Samuel20040521/flico/hardware/final-version/Gerber/SOC_Final_BOM.csv

Comment | Designator | Footprint | Quantity | Description | LCSC
0.1p | C1 | Capacitor_SMD:C_0603_1608Metric_Pad1.08x0.95mm_HandSolder | 1 | Capacitor 0.1p 0603
1p | C2 | Capacitor_SMD:C_0603_1608Metric_Pad1.08x0.95mm_HandSolder | 1 | Capacitor 1p 0603
10p | C3 | Capacitor_SMD:C_0603_1608Metric_Pad1.08x0.95mm_HandSolder | 1 | Capacitor 10p 0603
100p | C4 | Capacitor_SMD:C_0603_1608Metric_Pad1.08x0.95mm_HandSolder | 1 | Capacitor 100p 0603
1n | C5 | Capacitor_SMD:C_0603_1608Metric_Pad1.08x0.95mm_HandSolder | 1 | Capacitor 1n 0603
10n | C6 | Capacitor_SMD:C_0603_1608Metric_Pad1.08x0.95mm_HandSolder | 1 | Capacitor 10n 0603
100n | C7 | Capacitor_SMD:C_0603_1608Metric_Pad1.08x0.95mm_HandSolder | 1 | Capacitor 100n 0603
1u | C8 | Capacitor_SMD:C_0603_1608Metric_Pad1.08x0.95mm_HandSolder | 1 | Capacitor 1u 0603
Conn_01x03_Socket | J1 | Connector_PinSocket_2.54mm:PinSocket_1x03_P2.54mm_Vertical | 1 | Pin header/socket
Conn_01x04_Socket | J3 | Connector_PinSocket_2.54mm:PinSocket_1x04_P2.54mm_Vertical | 1 | Pin header/socket
100M | R1 | Resistor_SMD:R_0603_1608Metric_Pad0.98x0.95mm_HandSolder | 1 | Resistor 100M 0603
1k | R2,R8 | Resistor_SMD:R_0603_1608Metric_Pad0.98x0.95mm_HandSolder | 2 | Resistor 1k 0603
32k | R3 | Resistor_SMD:R_0603_1608Metric_Pad0.98x0.95mm_HandSolder | 1 | Resistor 32k 0603
10M | R4 | Resistor_SMD:R_0603_1608Metric_Pad0.98x0.95mm_HandSolder | 1 | Resistor 10M 0603
1M | R5 | Resistor_SMD:R_0603_1608Metric_Pad0.98x0.95mm_HandSolder | 1 | Resistor 1M 0603
100k | R6 | Resistor_SMD:R_0603_1608Metric_Pad0.98x0.95mm_HandSolder | 1 | Resistor 100k 0603
10k | R7 | Resistor_SMD:R_0603_1608Metric_Pad0.98x0.95mm_HandSolder | 1 | Resistor 10k 0603
100 | R9 | Resistor_SMD:R_0603_1608Metric_Pad0.98x0.95mm_HandSolder | 1 | Resistor 100 0603
10 | R10 | Resistor_SMD:R_0603_1608Metric_Pad0.98x0.95mm_HandSolder | 1 | Resistor 10 0603
SFH2440 | SFH2440 | OptoDevice:Osram_SFH2440 | 1 | SFH2440
OPA320AIDBVR | U1 | OPA320AIDBVR:SOT95P280X145-5N | 1 | IC OPA320AIDBVR
TMUX1208PW | U2 | Package_SO:TSSOP-16_4.4x5mm_P0.65mm | 1 | IC TMUX1208PW
