Samuel20040521/flico/hardware/second-version/PD_detector_pro.kicad_pcb

## KiCad design hardware/second-version/PD_detector_pro.kicad_pcb (2026-06-07)

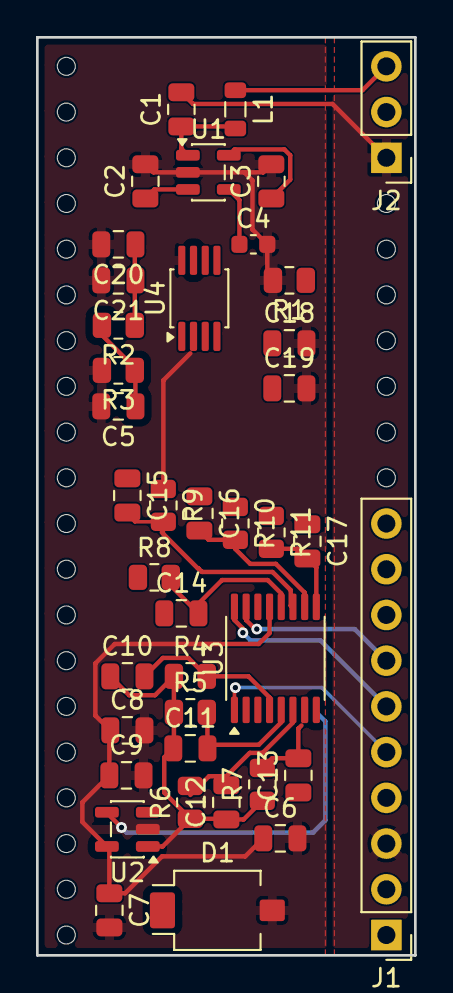
[picture p15: board PD_detector_pro.kicad_pcb from above]

Board: 2 copper layers, 21.0 x 51.0 mm, 41 parts (0 on the bottom side), 24 nets.

Parts:
C1, C2, C3: 1uF; C_0805_2012Metric
C4: 10nF; C_0603_1608Metric
C5, C6, C8, C18, C20: 100nF; C_0805_2012Metric
C7, C9, C19, C21: 10uF; C_0805_2012Metric
C10: 10nF; C_0805_2012Metric
C11: 3.3nF; C_0805_2012Metric
C12: 1nF; C_0805_2012Metric
C13: 330pF; C_0805_2012Metric
C14: 100pF; C_0805_2012Metric
C15: 33pF; C_0805_2012Metric
C16: 10pF; C_0805_2012Metric
C17: DNP; C_0805_2012Metric
D1: SFH2440; Osram_SFH2440
J1: Conn_01x10; PinHeader_1x10_P2.54mm_Vertical
J2: Conn_01x03; PinHeader_1x03_P2.54mm_Vertical
L1: 600R@100MHz; L_0805_2012Metric
PICO_PINS: Pico_thru
R1: 0; R_0805_2012Metric
R2, R8: 100k; R_0805_2012Metric
R3: 4.7k; R_0805_2012Metric
R4: 1k; R_0805_2012Metric
R5: 3.3k; R_0805_2012Metric
R6: 10k; R_0805_2012Metric
R7: 33k; R_0805_2012Metric
R9: 330k; R_0805_2012Metric
R10: 1M; R_0805_2012Metric
R11: 10M; R_0805_2012Metric
U1: LP5907MFX-3.3; SOT-23-5
U2: OPA320AIDBVR; SOT-23-5
U3: TMUX1208PWR; TSSOP-16_4.4x5mm_P0.65mm
U4: ADS8326; MSOP-8_3x3mm_P0.65mm

Connections:
+3V3_A: C3.1, C6.1, C7.1, C8.1, C9.1, C18.1, C19.1, C20.1, C21.1, R2.1, U1.5, U2.5, U3.13, U4.1, U4.8
GEAR0: C10.2, R4.2, U3.4
GEAR1: C11.2, R5.2, U3.5
GEAR2: C12.2, R6.2, U3.6
GEAR3: C13.2, R7.2, U3.7
GEAR4: C14.2, R8.2, U3.12
GEAR5: C15.2, R9.2, U3.11
GEAR6: C16.2, R10.2, U3.10
GEAR7: C17.2, R11.2, U3.9
GND: C1.2, J1.3, J2.1, R1.1
GNDA: C2.2, C3.2, C4.2, C5.2, C6.2, C7.2, C8.2, C9.2, C18.2, C19.2, C20.2, C21.2, D1.2, R1.2, R3.2, U1.2, U2.2, U3.14, U4.4
LDO_BYP: C4.1, U1.4
MUX_A0: J1.5, U3.1
MUX_A1: J1.6, U3.16
MUX_A2: J1.7, U3.15
MUX_EN: J1.8, U3.2
SPI_CS: J1.2, U4.5
SPI_SCK: J1.4, U4.7
SPI_SDO: J1.1, U4.6
TIA_OUT: C10.1, C11.1, C12.1, C13.1, C14.1, C15.1, C16.1, C17.1, R4.1, R5.1, R6.1, R7.1, R8.1, R9.1, R10.1, R11.1, U2.1, U4.2
TIA_SUM: D1.1, U2.4, U3.8
VBUS: J2.3, L1.1
VBUS_FILT: C1.1, C2.1, L1.2, U1.1, U1.3
V_REF: C5.1, R2.2, R3.1, U2.3, U4.3
