Samuel20040521/flico/hardware/first-version/pico_flicker_shield.kicad_pcb

## KiCad design hardware/first-version/pico_flicker_shield.kicad_pcb (2026-06-07)

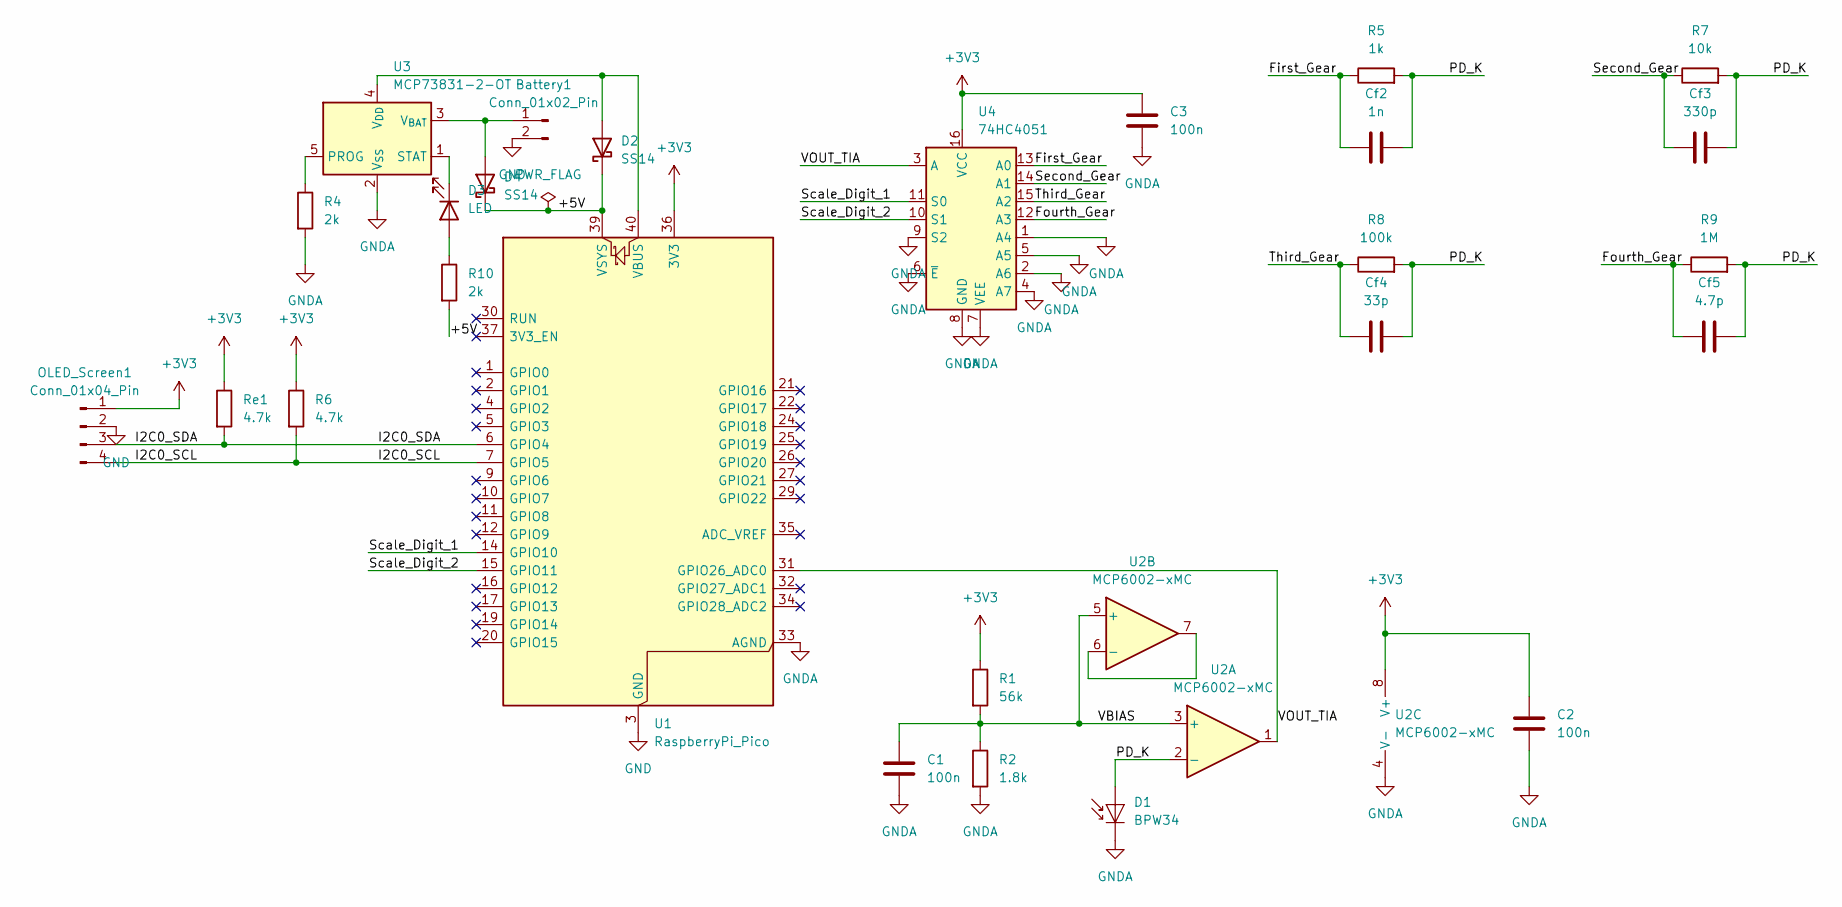
[picture p16: schematic pico_flicker_shield.kicad_sch]

Parts:
Battery1: Conn_01x02_Pin
C1, C3: 100n; C_0805_2012Metric; LCSC C49645
C2: 100n; C_0805_2012Metric
Cf2: 1n; C_0805_2012Metric
Cf3: 330p; C_0805_2012Metric
Cf4: 33p; C_0805_2012Metric
Cf5: 4.7p; C_0805_2012Metric
D1: BPW34; Osram_DIL2_4.3x4.65mm_P5.08mm
D2, D4: SS14; D_SMA
D3: LED; LED_0805_2012Metric
OLED_Screen1: Conn_01x04_Pin; PinHeader_1x04_P2.54mm_Vertical
R1: 56k; R_0805_2012Metric; LCSC C17414
R2: 1.8k; R_0805_2012Metric
R4, R10: 2k; R_0805_2012Metric; LCSC C17414
R5: 1k; R_0805_2012Metric
R6: 4.7k; R_0805_2012Metric; LCSC C17630
R7: 10k; R_0805_2012Metric
R8: 100k; R_0805_2012Metric
R9: 1M; R_0805_2012Metric
Re1: 4.7k; R_0805_2012Metric; LCSC C17630
U1: RaspberryPi_Pico; RaspberryPi_Pico_Common_THT
U2: MCP6002-xMC; MSOP-8_3x3mm_P0.65mm
U3: MCP73831-2-OT; SOT-23-5
U4: 74HC4051; SOIC-16_3.9x9.9mm_P1.27mm

Connections:
+3V3: C2.1, C3.1, OLED_Screen1.1, R1.1, R6.1, Re1.1, U1.36 (3V3), U2.8 (V+), U4.16 (VCC)
/+5V: D2.1 (K), D4.1 (K), R10.2, U1.39 (VSYS)
/First_Gear: Cf2.1, R5.1, U4.13 (A0)
/Fourth_Gear: Cf5.1, R9.1, U4.12 (A3)
/I2C0_SCL: OLED_Screen1.4, R6.2, U1.7 (GPIO5)
/I2C0_SDA: OLED_Screen1.3, Re1.2, U1.6 (GPIO4)
/PD_K: Cf2.2, Cf3.2, Cf4.2, Cf5.2, D1.2 (A), R5.2, R7.2, R8.2, R9.2, U2.2 (-)
/Scale_Digit_1: U1.14 (GPIO10), U4.11 (S0)
/Scale_Digit_2: U1.15 (GPIO11), U4.10 (S1)
/Second_Gear: Cf3.1, R7.1, U4.14 (A1)
/Third_Gear: Cf4.1, R8.1, U4.15 (A2)
/VBIAS: C1.1, R1.2, R2.1, U2.3 (+), U2.5 (+)
/VOUT_TIA: U1.31 (GPIO26_ADC0), U2.1, U4.3 (A)
GND: Battery1.2, OLED_Screen1.2, U1.3 (GND), U1.8 (GND), U1.13 (GND), U1.18 (GND), U1.23 (GND), U1.28 (GND), U1.38 (GND)
GNDA: C1.2, C2.2, C3.2, D1.1 (K), R2.2, R4.2, U1.33 (AGND), U2.4 (V-), U2.9 (V-), U3.2 (V_{SS}), U4.1 (A4), U4.2 (A6), U4.4 (A7), U4.5 (A5), U4.6 (~E), U4.7 (VEE), U4.8 (GND), U4.9 (S2)
unnamed: Battery1.1, D4.2 (A), U3.3 (V_{BAT})
unnamed: D2.2 (A), U1.40 (VBUS), U3.4 (V_{DD})
unnamed: D3.2 (A), R10.1
unnamed: D3.1 (K), U3.1 (STAT)
unnamed: U2.6 (-), U2.7
unnamed: R4.1, U3.5 (PROG)

Board: 2 copper layers, 26 parts (0 on the bottom side), 21 nets, no tracks yet.
