Samuel20040521/flico/hardware/final-version/SOC_Final.kicad_pcb

## KiCad design hardware/final-version/SOC_Final.kicad_pcb (2026-06-07)

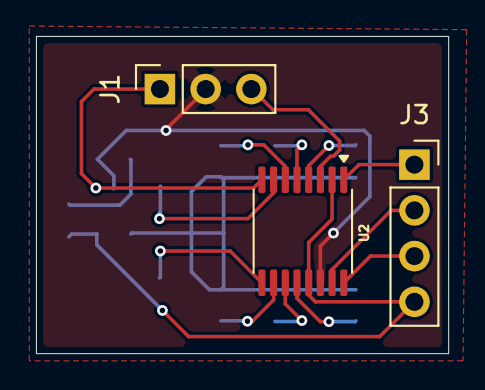
[picture p17: board SOC_Final.kicad_pcb from above]

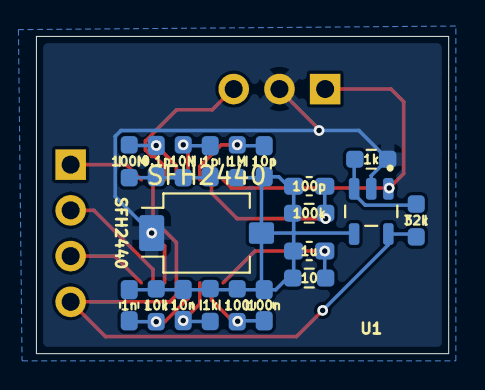
[picture p18: board SOC_Final.kicad_pcb from below]

Board: 2 copper layers, 22.9 x 17.6 mm, 23 parts (20 on the bottom side), 17 nets.

Parts:
C1: 0.1p; C_0603_1608Metric_Pad1.08x0.95mm_HandSolder
C2: 1p; C_0603_1608Metric_Pad1.08x0.95mm_HandSolder
C3: 10p; C_0603_1608Metric_Pad1.08x0.95mm_HandSolder
C4: 100p; C_0603_1608Metric_Pad1.08x0.95mm_HandSolder
C5: 1n; C_0603_1608Metric_Pad1.08x0.95mm_HandSolder
C6: 10n; C_0603_1608Metric_Pad1.08x0.95mm_HandSolder
C7: 100n; C_0603_1608Metric_Pad1.08x0.95mm_HandSolder
C8: 1u; C_0603_1608Metric_Pad1.08x0.95mm_HandSolder
J1: Conn_01x03_Socket; PinSocket_1x03_P2.54mm_Vertical
J3: Conn_01x04_Socket; PinSocket_1x04_P2.54mm_Vertical
R1: 100M; R_0603_1608Metric_Pad0.98x0.95mm_HandSolder
R2, R8: 1k; R_0603_1608Metric_Pad0.98x0.95mm_HandSolder
R3: 32k; R_0603_1608Metric_Pad0.98x0.95mm_HandSolder
R4: 10M; R_0603_1608Metric_Pad0.98x0.95mm_HandSolder
R5: 1M; R_0603_1608Metric_Pad0.98x0.95mm_HandSolder
R6: 100k; R_0603_1608Metric_Pad0.98x0.95mm_HandSolder
R7: 10k; R_0603_1608Metric_Pad0.98x0.95mm_HandSolder
R9: 100; R_0603_1608Metric_Pad0.98x0.95mm_HandSolder
R10: 10; R_0603_1608Metric_Pad0.98x0.95mm_HandSolder
SFH2440: SFH2440; Osram_SFH2440
U1: OPA320AIDBVR; SOT95P280X145-5N
U2: TMUX1208PW; TSSOP-16_4.4x5mm_P0.65mm

Connections:
0: J1.3, U2.3 (VSS)
/+3V3: J3.4, R3.2, U1.5 (V+), U2.2 (EN), U2.13 (VDD)
/GEAR1: C1.1, R1.1, U2.4 (S1)
/GEAR2: C2.1, R4.1, U2.5 (S2)
/GEAR3: C3.1, R5.1, U2.6 (S3)
/GEAR4: C4.1, R6.1, U2.7 (S4)
/GEAR5: C5.1, R7.1, U2.12 (S5)
/GEAR6: C6.1, R8.1, U2.11 (S6)
/GEAR7: C7.1, R9.1, U2.10 (S7)
/GEAR8: C8.1, R10.1, U2.9 (S8)
/GND_A: J1.2, R2.1, SFH2440.1 (K), U1.2 (V-), U2.14 (GND)
/MUX_A0: J3.1, U2.1 (A0)
/MUX_A1: J3.3, U2.16 (A1)
/MUX_A2: J3.2, U2.15 (A2)
/TIA_OUT: J1.1, U1.1 (OUT), U2.8 (D)
/TIA_SUM: C1.2, C2.2, C3.2, C4.2, C5.2, C6.2, C7.2, C8.2, R1.2, R4.2, R5.2, R6.2, R7.2, R8.2, R9.2, R10.2, SFH2440.2 (A), U1.4 (-IN)
/V_REF: R2.2, R3.1, U1.3 (+IN)
