Samuel20040521/flico/(commit log)

2026-06-03 Initialize flico research log with 2026-04-19 brainstorm entry
    flico (flicker + pico) is a self-built instrument that uses a Raspberry
    Pi Pico + BPW34 photodiode + MCP6004 TIA to measure screen flicker
    (PWM dimming frequency, ProMotion adaptive refresh, peak brightness).
    This first commit sets up the research log scaffolding:
    - report/research-log/log.tex — XeLaTeX + xeCJK + TW-Kai master file
    with a \logentry macro and biblatex+biber bibliography.
    - report/research-log/references.bib — empty starter bib.
    - report/research-log/entries/2026-04-19.tex — first entry, captures
    the brainstorming phase: starting from a naive (reverse-biased PD +
    load resistor + ADC + FFT) idea and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
2026-06-03 Add 2026-04-21 entry: first shopping trip to Guanghua market
    After the 4/19 brainstorming session, the next logical step was
    buying parts. This entry captures the in-store experience at
    今華電子 (Jinhua Electronics) in Guanghua market — using Gemini
    as a live shopping consultant while walking the aisles.
    Highlights:
    - 13 items bought at 今華 for NT$1,530 (multimeter, EIC-1104
    breadboard, MB-102 power module, 9V adapter, Raspberry Pi Pico,
    TM1637 display, BPW34 ×3, capacitor assortment, resistor pack,
    dupont wires, headers, BNC-to-alligator cable).
    - Op-amp (MCP6002 and all alternatives) was out of stock at 今華 —
    walked to 源達 next door and bought 2× MCP6004 (~NT$1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
2026-06-03 Add 2026-05-06 entry: bench TIA + PySpice cross-validation
    This was the day the analog front-end actually got built and the
    PySpice simulation environment was set up to cross-check it. The
    entry pulls together both efforts and the simulation/ directory
    holds the supporting code, models, data, and figures.
    Bench (afternoon, 2026-05-06):
    - Built a BPW34 + MCP6004 transimpedance amplifier on the EIC-1104
    breadboard with a small ~103 mV bias (56 kΩ / 1.8 kΩ divider) on
    the non-inverting input to keep V_OUT off the 0 V rail.
    - Designed four R_F / C_F pairs (1k/1n, 10k/330p, 100k/33p, 1M/1p)
    that keep R_F·C_F roughly constant so the -3 dB bandwidth lands
    in the 50–150 kHz band acros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
    [main.py]
2026-06-03 Add 0506.txt gemini chat history (companion to 2026-05-06 entry)
    The 2026-05-06 entry references on-the-fly Gemini consultation while
    building the TIA on the breadboard. This archives the verbatim chat:
    - Verifying MCP6004 VDD/VSS hookup before powering it up.
    - Designing the BPW34 + MCP6004 transimpedance amplifier topology
    (inverting input gets the photodiode cathode, anode to GND,
    R_F in feedback, 10 pF compensation cap on R_F).
    - Choosing four gain stages (1 kΩ / 10 kΩ / 100 kΩ / 1 MΩ) for the
    rotary switch idea, with a quick reading of the measured bench
    numbers (1.5 V room light, 0.6 V hand-shadowed, 3.3 V flashlight
    saturation) to motivate the chosen R_F values.
    - Why n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
2026-06-07 Add 2026-05-07 entry: soldering iron selection (TS101/TS21 → HS-02A)
    The day after the 5/6 bench day, soldering iron purchase finally
    goes on the order. The 4/21 Guanghua trip had deferred this to
    "online later" — this entry captures the research and decision.
    Selection logic, condensed:
    - Tip-system choice dominates everything else.
    - TS / T12: medium thermal mass, cheap tips, generalist.
    - C210: extremely precise, sub-millimeter tip-to-grip distance,
    but light thermal mass — struggles on BNC / thick wires.
    - C245: middle ground — keeps precision while having enough
    mass to drive bigger joints.
    - Miniware TS101 vs TS21 — TS101 (TS-series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
2026-06-07 Add firmware/led-light-test/blink.py: MicroPython + VS Code Pico hello world
    5/8 marked the project's pivot from analog-only bench work to digital
    acquisition via the Raspberry Pi Pico. Before wiring the Pico to the
    TIA output, the very first step was getting the toolchain alive:
    - VS Code with the MicroPython extension configured.
    - Pico flashed with the MicroPython firmware (UF2 drag-and-drop).
    - blink.py uploaded and run on the board to verify the
    edit -> save -> run loop works end-to-end.
    led-light-test/ subfolder is kept so future MicroPython sketches
    (Pico_Flicker main loop, OLED driver, etc.) can slot in next to it
    as siblings.
    Documenting events from 2026-05-08 (written 2026-06-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
2026-06-07 Add 2026-05-08 entry: Pico + MicroPython signal chain (no OLED yet)
    5/8 was the day the bench-side analog work plugged into the Pico for
    the first time. After the toolchain-bringup blink commit, the rest of
    the day produced a working ADC -> serial chain end-to-end: photodiode
    -> MCP6004 TIA -> Pico ADC -> USB-CDC stream -> pyserial PC reader.
    MicroPython is chosen as the prototyping runtime: edit/save/run is
    much faster than the C++ Pico SDK CMake-build-flash loop. The plan
    is to revisit C++ later only if MicroPython performance falls short
    (it eventually does -- see 2026-05-12).
    Notably: no display yet. The plan had been to also drive an
    I2C OLED on 5/8, but the 0.91" SSD1306 hadn't been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
    [main.py, read_data.py]
2026-06-07 Add 2026-05-11 entry: second Guanghua trip + first OLED bring-up + MUX insight
    5/11 was a three-front day:
    12:51 -- second trip to 今華電子 in Guanghua, picking up the parts
    that 4/21 missed (the op-amp had landed at 源達 instead) plus
    solutions for the two pain points 5/6 exposed (messy dupont wires
    and no rotary switch).
    13:25 -- pickup of the Fnirsi HS-02A soldering iron ordered on 5/7.
    Evening -- first time wiring the 0.91" SSD1306 OLED on I2C and
    writing the MicroPython driver (firmware/python-version/ssd1306.py)
    from scratch. 5/8 had originally planned for OLED but the part
    wasn't available; today closed that gap. The Pico can now display
    the instantaneous TIA voltage on its o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
    [ssd1306.py]
2026-06-07 Add 2026-05-12 entry: solder day, final breadboard, fork to C++ Pico SDK
    5/12 was the day three currents converged:
    1. The HS-02A iron picked up on 5/11 finally got used: Pico header
    pins soldered on, and BPW34 soldered onto a ~30 cm twin lead so
    the photodiode can be lifted off the breadboard and pressed flat
    against the device under test (matching the 5/3 proposal's
    "instrument you stand and use" form factor).
    2. The 74HC4051 MUX bought on 5/11 went into the circuit: COM to
    op-amp inv, Y0..Y3 to {1k, 10k, 100k, 1M} feedback resistors,
    S0/S1 to Pico GPIOs, S2 grounded. The four-gear gain switch is
    no longer a pile of dupont wires being yanked by hand.
    3. With everythin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
    [blink.c, main.cpp]
2026-06-07 Add 2026-05-18 entry: design first-version PCB (PD_detector_pro)
    5/18 was a full-day PCB layout session in KiCad. Goal was *not* to
    ship a board to JLCPCB — too many specs (sensor choice, battery
    inclusion, ADC software chain) hadn't converged yet. Goal was to:
    1) get the SKiDL → KiCad netlist → pcbnew Python API pipeline working
    2) survey what the breadboard-grade parts (MCP6002 + 74HC4051 + Pico ADC)
    would look like if upgraded to lab-grade (OPA328 + TMUX1208 + ADS8326)
    3) commit the design to hardware/first-version/ as a reference snapshot
    Files added:
    - hardware/first-version/
    - gen_schematic.py / gen_schematic_sklib.py: SKiDL DSL for the schematic
    - pd_detector.net: 40KB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
    [PD_detector_pro.kicad_pcb, PD_detector_pro.kicad_sch]
2026-06-07 Add 2026-05-19 entry: rewrite host/ from Python (matplotlib → PyQtGraph) to Rust
    5/19 documents the host-side plotting story arc that ran from 5/8 to today:
    1. matplotlib + plt.ion() (5/8–5/12): worked for the first signal-chain
    bringup but flickered on macOS retina — backend redraws desync from
    60Hz V-sync. Capped at ~20 fps even with tiny windows.
    2. PyQtGraph + OpenGL (5/13–5/18): solved the flicker (Qt double-buffering
    + V-sync) but hit an architectural ceiling at ~3e4 accumulated samples —
    numpy↔Qt copies, GIL/serial-thread contention, and Python-side
    tessellation drop FPS to 0.5 for a 30s @ 10kHz measurement.
    3. Rust + eframe/egui/egui_plot (today): immediat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
2026-06-07 Rename PD_detector_pro to second-version; add pico_flicker_shield as the real first-version
    The previous 5/18 commit named PD_detector_pro 'first-version' — that
    was wrong. The actual first PCB attempt was pico_flicker_shield,
    started in KiCad on 2026-05-08 right after the MicroPython signal
    chain came online. It used the traditional KiCad GUI workflow
    (Schematic Editor → Footprint Assignment → PCB Editor) and ran for
    ~10 days of intermittent edits before being abandoned on 5/18 in
    favor of the SKiDL programmatic flow.
    Folder changes:
    - hardware/first-version/ ← NEW. pico_flicker_shield from 5/8.
    .kicad_sch (168 KB, last touched 5/8 17:08)
    .kicad_pcb (148 KB, layout was sti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
    [PD_detector_pro.kicad_pcb, PD_detector_pro.kicad_sch, pico_flicker_shield.kicad_pcb, pico_flicker_shield.kicad_sch]
2026-06-07 Add 2026-05-20 entry: final PCB (SOC_Final) — design, simulation, JLCPCB submission on 5/25
    5/20 was the kickoff of the third and final PCB attempt that ran for
    six days. The entry covers the entire arc from blank schematic to
    JLCPCB submission, including the parallel host/ UI/UX iteration.
    Day-by-day:
    - Day 1 (5/20): blank schematic → first ERC run at 15:53 (ERC.rpt
    timestamp). Wrote tools/silkscreen_normalize.py to bulk-format
    reference designators. Recorded two breadboard CSVs (13:26, 13:28)
    to seed Day 3's spice simulation.
    - Day 2 (5/21): schematic complete + footprints + LCSC binding.
    Pragmatic downgrades vs second-version: MCP6004 instead of OPA328
    (Basic Part, sufficie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
    [SOC_Final-B_Cu.gbl, SOC_Final-B_Mask.gbs, SOC_Final-B_Paste.gbp, SOC_Final-B_Silkscreen.gbo, SOC_Final-Edge_Cuts.gm1, SOC_Final-F_Cu.gtl, SOC_Final-F_Mask.gts, SOC_Final-F_Paste.gtp]
2026-06-07 Add host/ Rust GUI crate (rust_flico): companion to 2026-05-19 entry
    The 5/19 entry documents abandoning Python (matplotlib → PyQtGraph) for
    Rust + eframe/egui due to performance ceilings beyond 3×10^4 samples.
    This commit lands the actual Rust code referenced by that entry.
    Layout:
    - host/Cargo.toml — crate manifest (crate name stays `rust_flico`;
    CLAUDE.md explains the kept name vs the new
    host/ directory).
    - host/Cargo.lock — pinned deps as of 5/19 commit (eframe 0.29,
    egui_plot, realfft, rustfft, serialport,
    crossbeam-channel).
    - host/src/main.rs —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
2026-06-07 Add host/convert.py + measured-noise PWL + 4 baseline CSVs: companion to 2026-05-20 entry
    The 5/20 entry calls the "measured CSV → PWL → KiCad spice" pipeline
    the proudest methodology of the project — but the actual files were
    still in SOC_Final/host/. This commit lands them next to the Rust GUI:
    - host/convert.py — pandas script that reads a host/-exported
    flicker_*.csv and emits a KiCad-compatible
    PWL noise source (kicad_noise_pwl.txt).
    Used 5/22 to drive TIA_Gain_100M.wbk with
    real BPW34 1/f + 60 Hz crosstalk noise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
    [flicker_1779254801.csv, flicker_1779254893.csv, flicker_1779717476.csv, flicker_1779717721.csv]
2026-06-07 Add release-rust_flico CI workflow
    GitHub Actions workflow that cross-compiles the host/ Rust GUI and
    publishes release binaries on tag push:
    - macOS universal binary (x86_64 + aarch64 lipo'd together).
    - Windows x86_64 binary.
    The 5/19 entry's 下一步 ④ explicitly tags this CI as "to be done the
    next day (5/20)" — landing it here as a logical companion to that arc.
    Workflow keeps the original artifact name `rust_flico` (matching the
    crate name) so links and downloads stay stable.
2026-06-07 Add mechanical/ stubs + 展望 section: future-work response to maker spirit
    老師第二堂課鼓勵「自己畫 PCB、自己 3D 列印」的創客精神 — PCB 那條線
    三版已走完(first/second/final-version + JLCPCB 投產),3D 列印這條
    線還在學,但起手已經對齊。本 commit 把進行中的 mechanical/ 起手
    產出搬入,並在 log.tex 末尾加上「展望」section 把這條線講清楚。
    mechanical/ 內容(stub 級別,不是成品):
    - fusion_pico_fixture.py — Fusion 360 嵌入式 Python script,
    用 adsk.fusion API parametrically
    生成 Pico + SFH 2440 photodiode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
2026-06-07 Add CLAUDE.md: handoff doc for next Claude session
    flico-fresh 是 SOC_Final 的線性故事版,內容已逐步補齊到 4/19→展望
    完整時間軸。本檔給下一個 Claude session 用:
    - 兩個 repo 角色對映表(flico-fresh = 給人看 / SOC_Final = 真正幹活)
    - 子資料夾 → SOC_Final 對映,方便未來補檔知道去哪撈
    - 寫研究日誌的模板(\logentry + entries/ + figures/ + 編譯流程)
    - 跨資料夾耦合圖
    - 已補完項(A/B/C/E/F)與剩餘缺口(D 主報告、G 6/2 起手條目、H README、
    pico-project/main.py 用途待問)
    - 不要做的事(不憑空寫日誌、不動已完成 entry、不搬 .history/.bak)
    - 18 個 commit 的清單,標註哪些是 6/7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
2026-06-07 Add README.md: project intro + folder map + local run instructions
    flico-fresh 的對外門面。從 SOC_Final/README.md 的骨架改寫,反映新結構:
    - 三版 hardware/{first,second,final}-version 線性史(取代原本的 main_board/
    shield 平行分類)
    - firmware 雙路線:cpp-version(主要)/ python-version(歷史)+ 兩個 led-light-test
    - host 改成 Rust(eframe + egui)而非舊 Python pyserial 描述
    - mechanical/ 標示為「進行中」,呼應 log.pdf 結尾的展望 section
    - 「實測噪音 → PWL → spice」pipeline 寫成具體 host/convert.py 指令
    - 各子資料夾的快速啟動指令,涵蓋 host / firmware / simulation / hardware /
    mechanical / research-log
    剩 D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
2026-06-07 Update CLAUDE.md: mark H (README.md) done, dismiss pico-project/main.py
2026-06-07 Add report/main.tex: flico 期末主報告(麵包板版現況 + PCB 版未來展望)
    10 頁的 XeLaTeX 主報告,跟 research-log 同套排版(TW-Kai + AutoFakeBold)。
    跟 research-log 是「敘事體姊妹篇」的關係 — research-log 寫每天的事件流,
    main.tex 寫「裝置作為一個系統的最終樣貌」。
    內容大綱:
    - §1 前言:為什麼要量「看不見的閃」(IEEE 1789 動機 + 4 個設計目標)
    - §2 系統概觀:5 級訊號鏈 + BOM 表
    - §3 電路設計(麵包板版現況):
    - TIA 拓樸(零偏壓設計理由)
    - 巧思 1:4 檔 R_f×C_f 全部對齊 10μs → 共用 f_c ≈ 16 kHz
    (含 R_f / C_f 配對表)
    - 巧思 2:74HC4051 mux 把波段開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
